Nrpickle/BIS/doc/display board/BIS Display Board Prototype - Initial Build.jpg

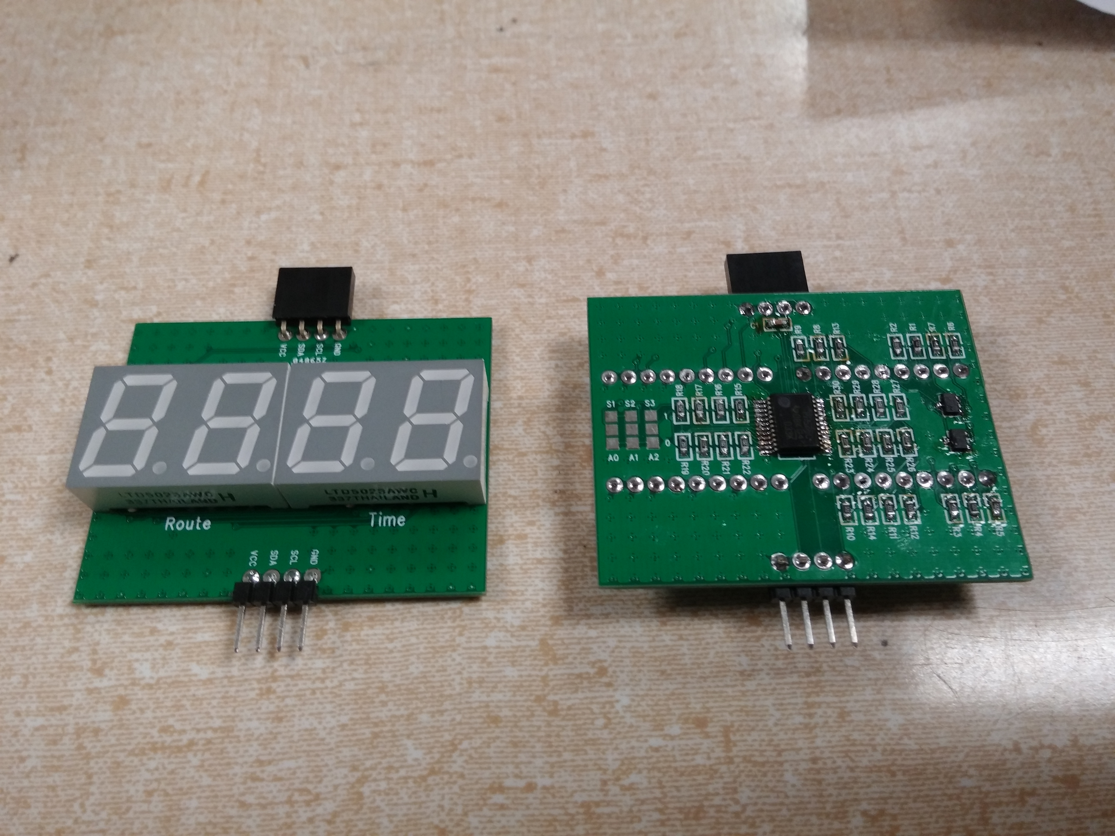
doc/display board/BIS Display Board Prototype - Initial Build.jpg
