Nrpickle/BIS/doc/display board/7 segment configuration.jpg

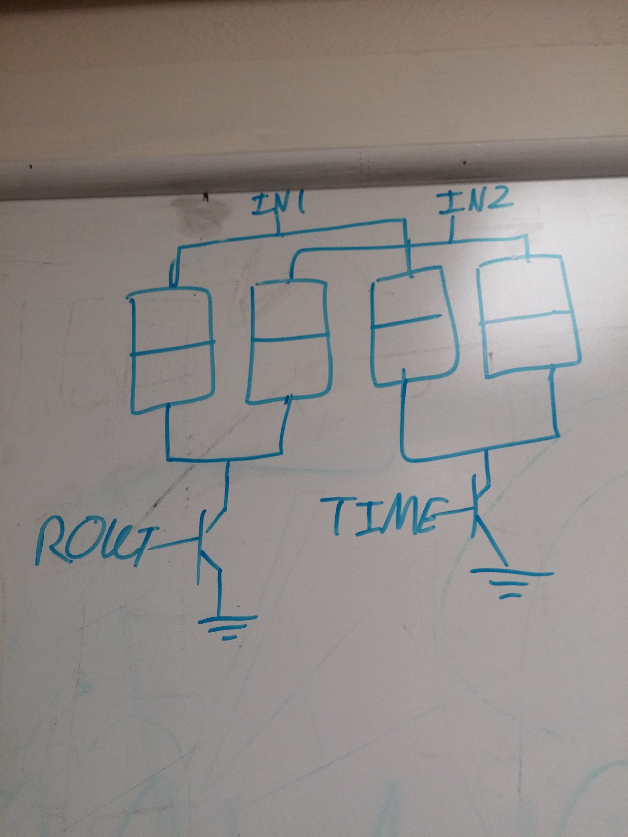
doc/display board/7 segment configuration.jpg
