Nrpickle/BIS/README.md

BIS
===

A repo for my Bus Information System. 

This device will take the bus route information from the Corvallis (OR) transit system and output it on 7 segment displays. 

This project is my first experience with the ESP8266 $5 WiFi module.
