Nrpickle/BIS/doc/display board/I2C Breakout v 0_1 Prototype Schematic.png

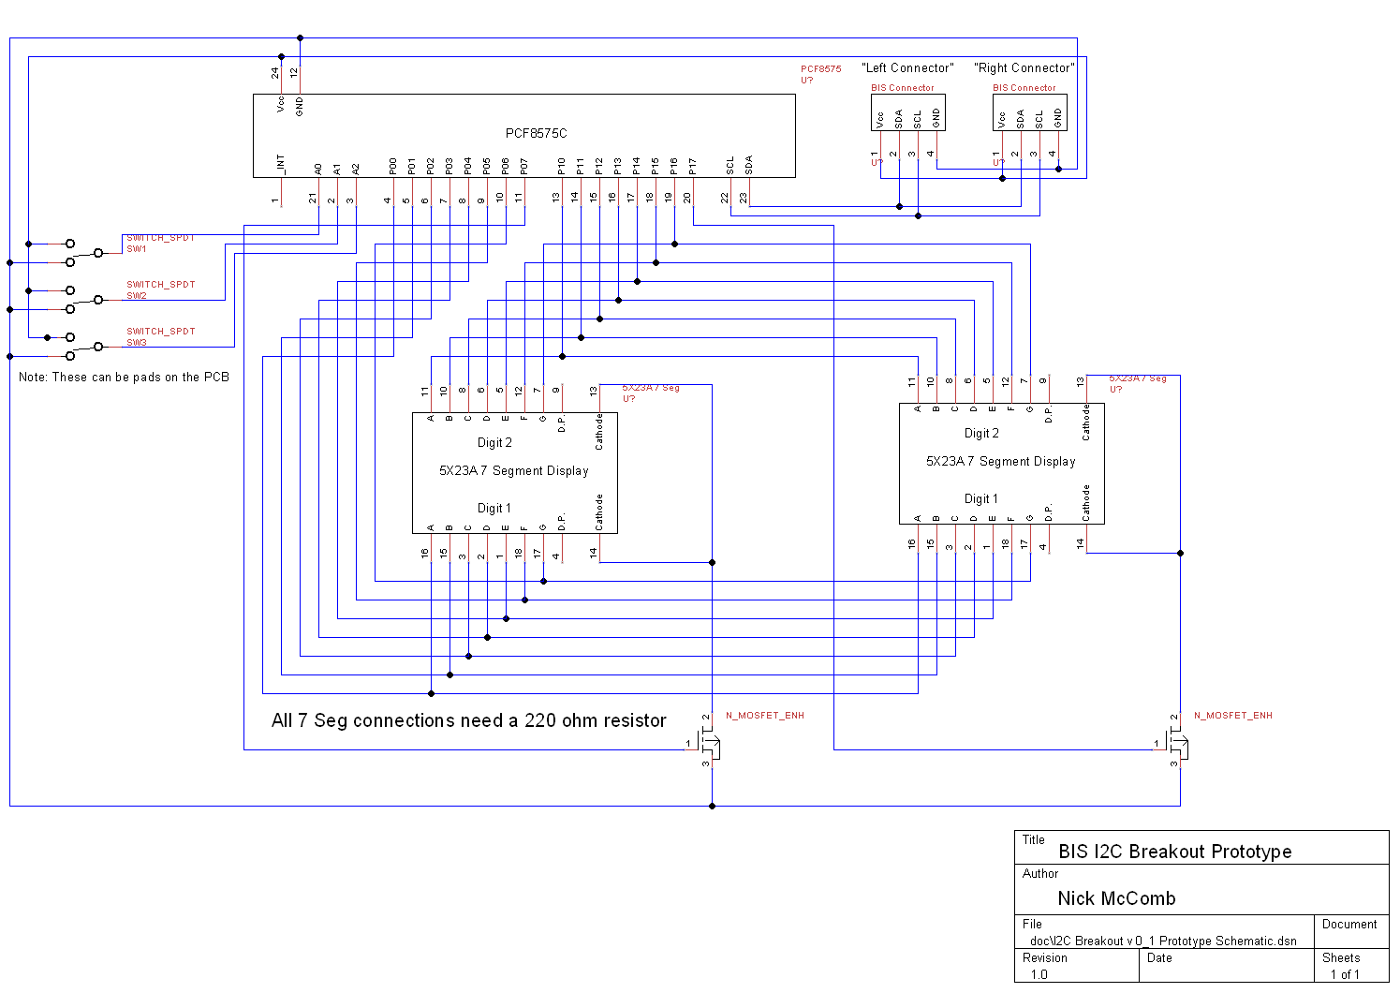
doc/display board/I2C Breakout v 0_1 Prototype Schematic.png
