Nrpickle/BIS/doc/display board/I2C-Breakout-Board-Layout.png

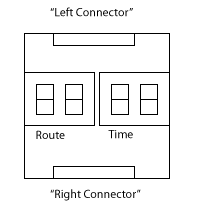
doc/display board/I2C-Breakout-Board-Layout.png
