Nrpickle/BIS/doc/display board/rev2/I2C Breakout v0.2 Prototype Schematic Sheet 1.png

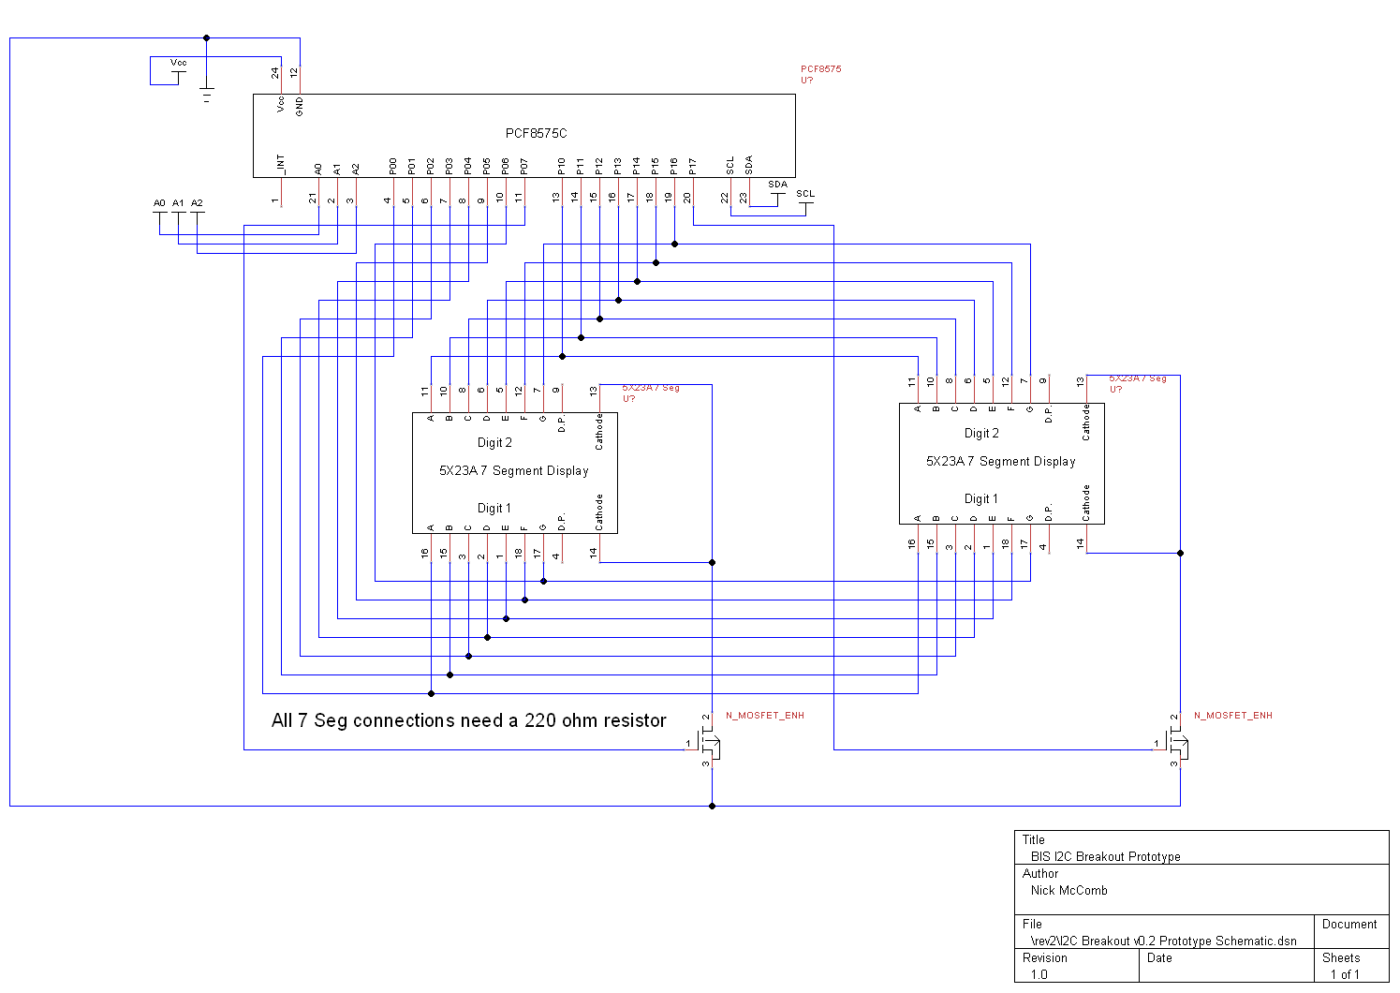
doc/display board/rev2/I2C Breakout v0.2 Prototype Schematic Sheet 1.png
