Nrpickle/BIS/doc/esp-01 pinout.png

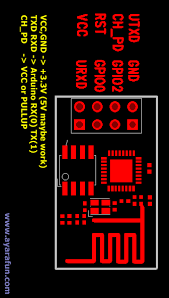
doc/esp-01 pinout.png
