Nrpickle/BIS/hardware/Drive Board/Schematic.png

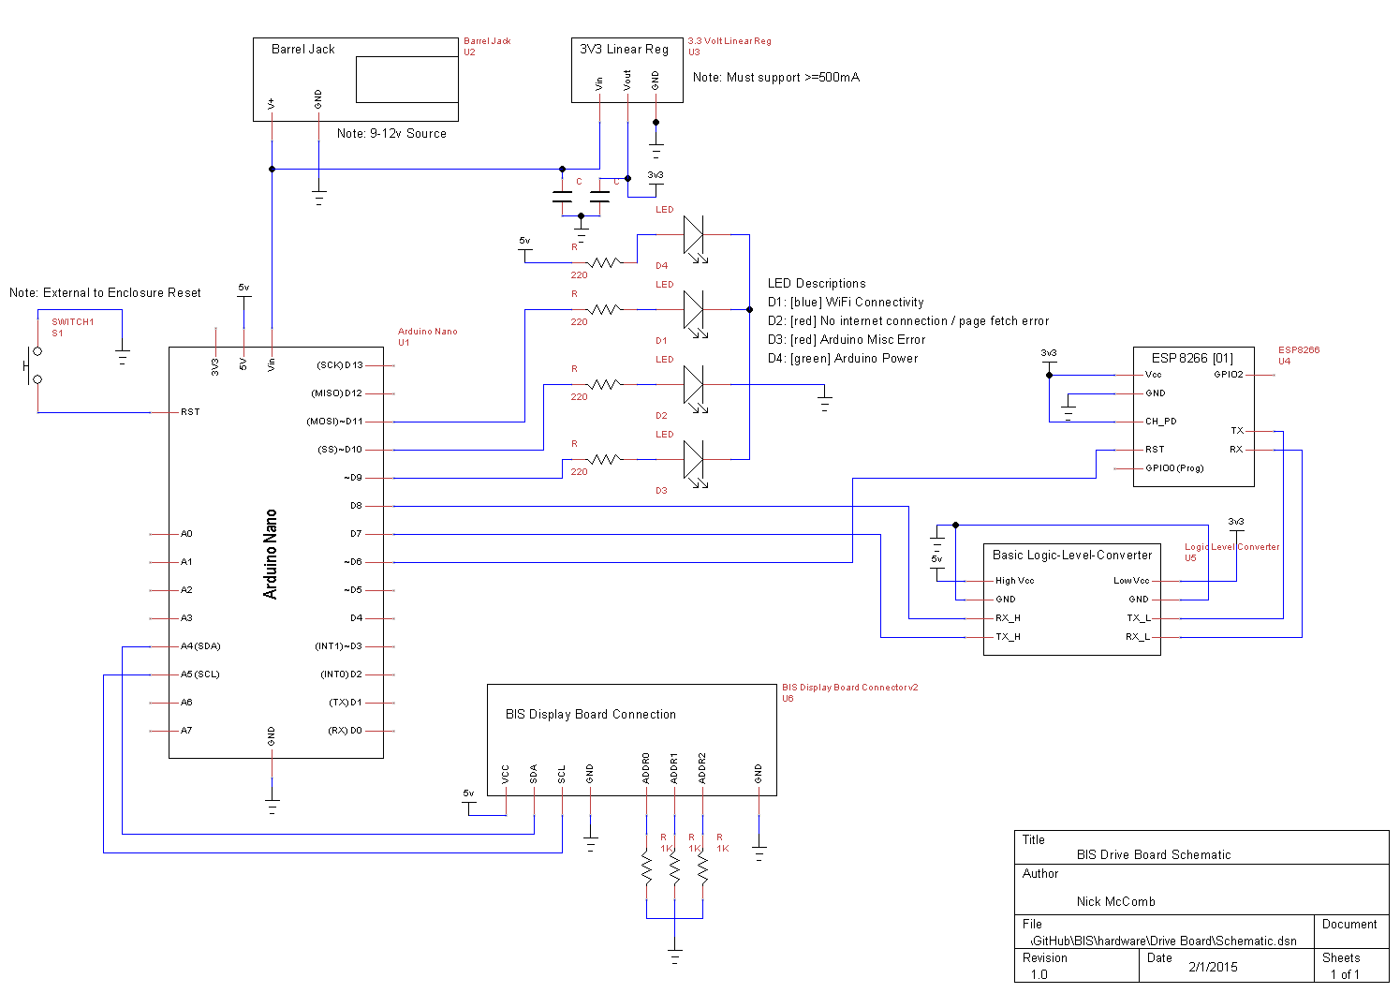
hardware/Drive Board/Schematic.png
