Nrpickle/BIS/hardware/ESP8266 Dev Board/Schematic.png

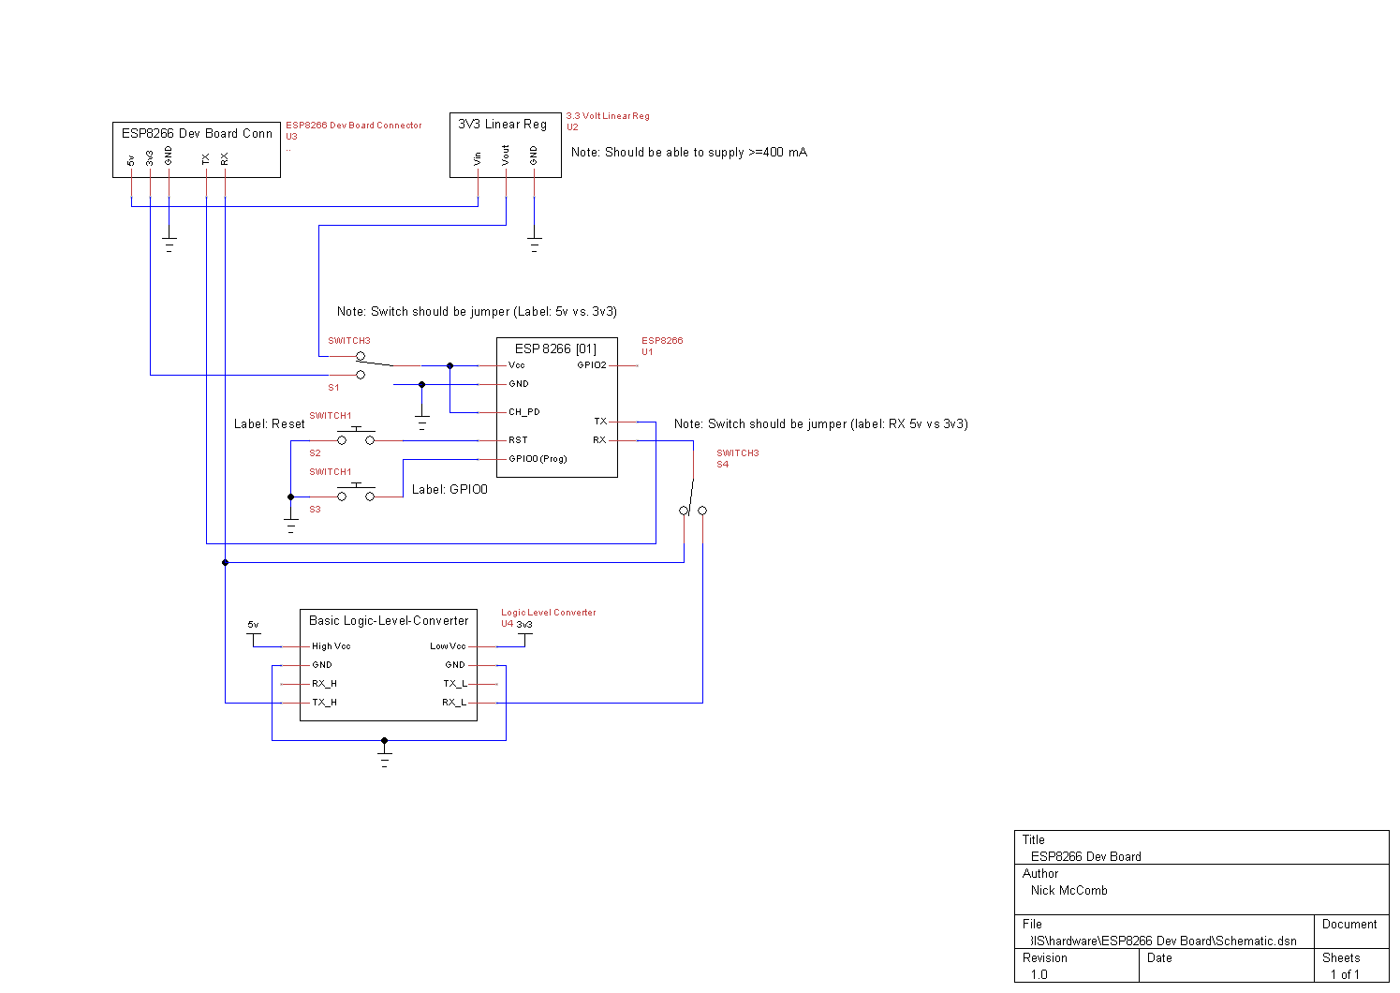
hardware/ESP8266 Dev Board/Schematic.png
