Nrpickle/BIS/hardware/Display Board Enclosure/Bottom Case.SLDPRT

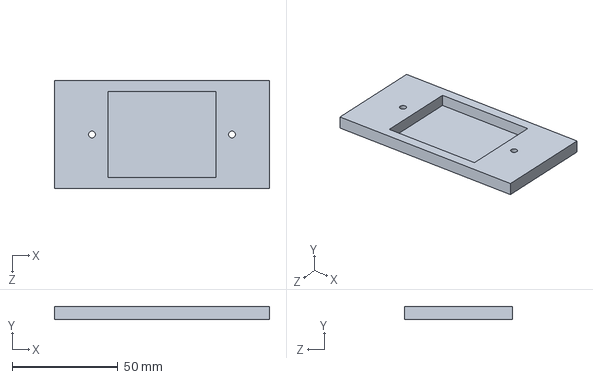
[picture p10: CAD file, 2015-01-18]
hardware/Display Board Enclosure/Bottom Case.SLDPRT
101.6 x 6.00 x 50.8 mm
