Nrpickle/BIS/hardware/Display Board Enclosure/Top Case.SLDPRT

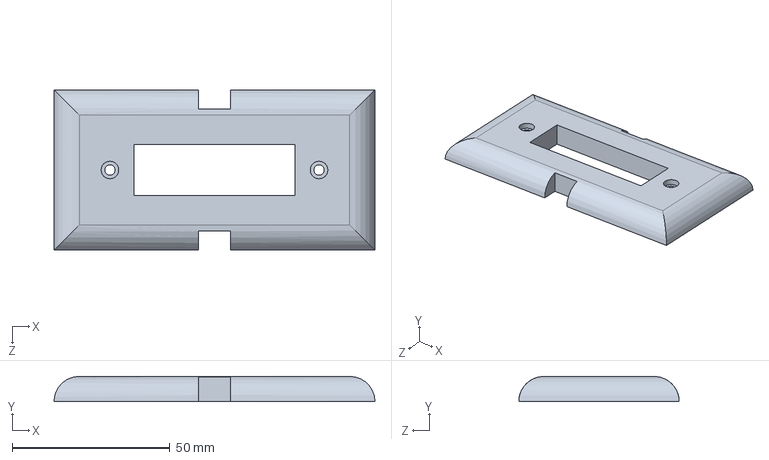
[picture p11: CAD file, 2015-01-18]
hardware/Display Board Enclosure/Top Case.SLDPRT
101.6 x 8.00 x 50.8 mm
