Nrpickle/BIS/hardware/Display Board/rev1/BIS_Display.pdf

D

6 | 5 | 4 | 3 | 2 | 1

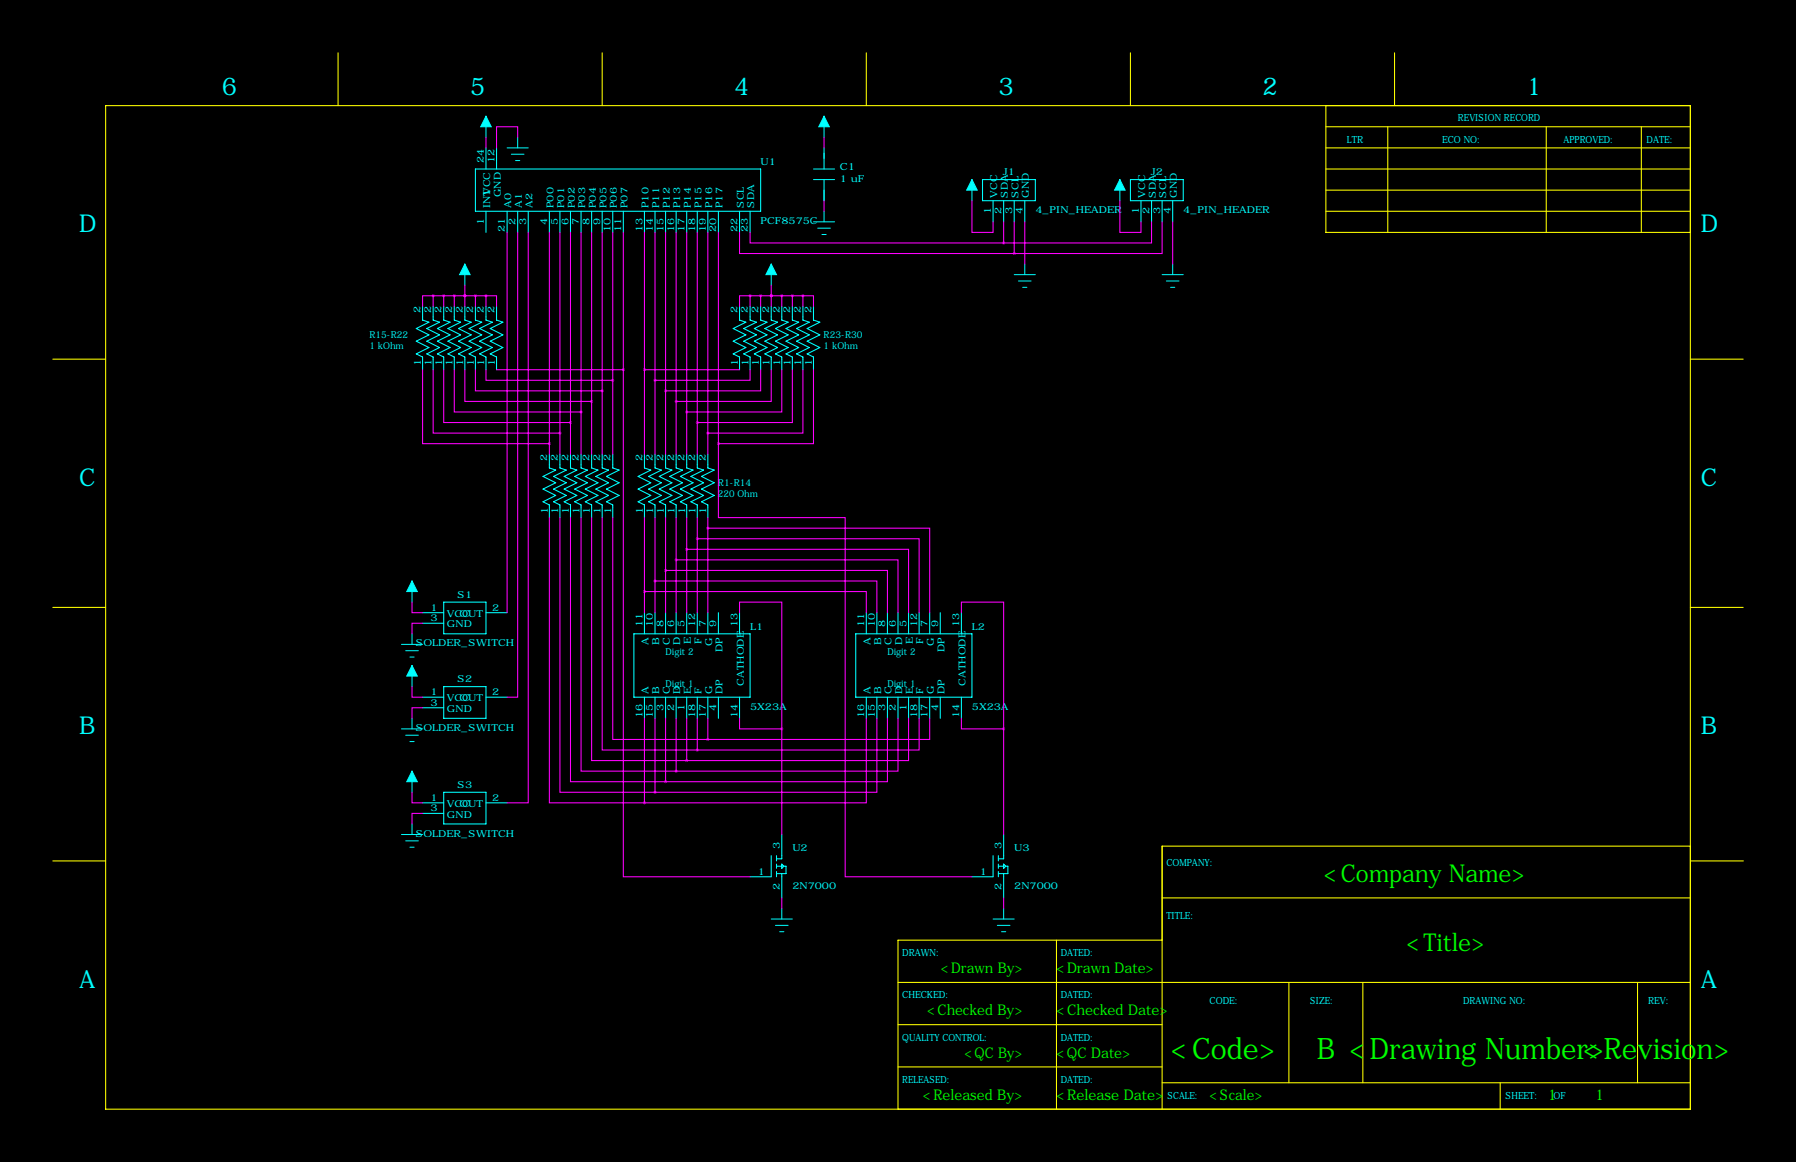
[picture p12: page 1]

REVISION RECORD

LTR | ECO NO: | APPROVED: | DATE:

DRAWN: <Drawn By> | DATED: <Drawn Date>

CHECKED: <Checked By> | DATED: <Checked Date> | CODE: | SIZE: | DRAWING NO: | REV:

QUALITY CONTROL: <QC By> | DATED: <QC Date>

RELEASED: <Released By> | DATED:

<Scale> SCALE: | 1 1 SHEET: OF
