Nrpickle/BIS/(list of files, drawings)

Other design files:
doc/display board/I2C Breakout v 0_1 Prototype Schematic.dsn
doc/display board/rev2/I2C Breakout v0.2 Prototype Schematic.dsn
hardware/Display Board/rev1/BIS_Display.pcb
hardware/Drive Board/Schematic.dsn
hardware/ESP8266 Dev Board/Schematic.dsn
