Nrpickle/BIS/hardware/I2C Expander/Sparkfun PCF8575C_Breakout-v10/PCF8575C_v10 Indivdual.brd

## EAGLE design hardware/I2C Expander/Sparkfun PCF8575C_Breakout-v10/PCF8575C_v10 Indivdual.brd (2014-12-12)

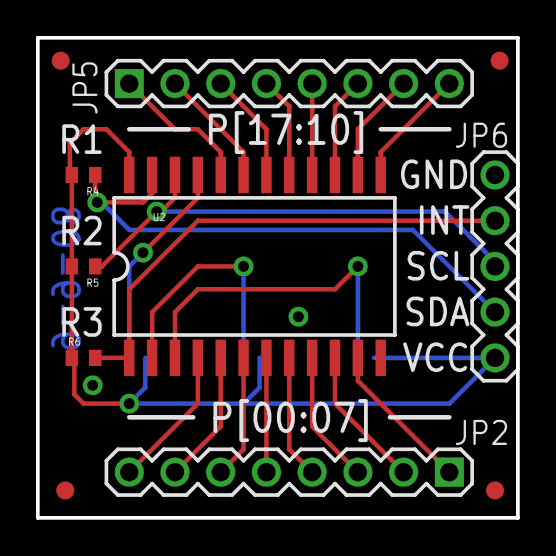
[picture p13: board PCF8575C_v10 Indivdual.brd from above]

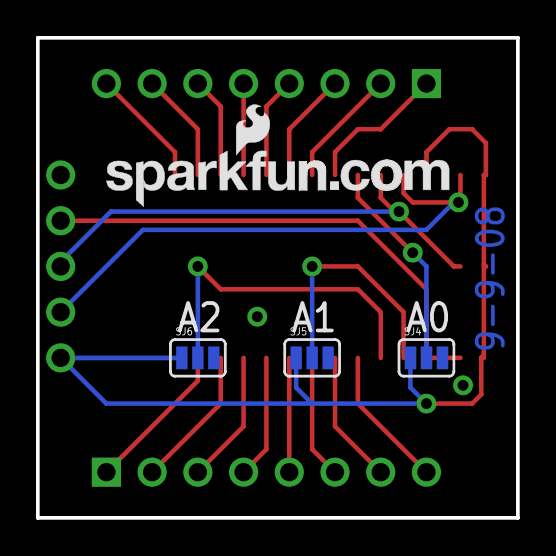
[picture p14: board PCF8575C_v10 Indivdual.brd from below]

Board: 2 copper layers, 26.7 x 26.7 mm, 15 parts (4 on the bottom side), 24 nets.

Parts:
E$5, E$6, E$7, E$8: FIDUCIAL-1X2
JP2, JP5: 1X08
JP6: 1X05
R4, R5, R6: C0402
SJ4: A0; SJ_3
SJ5: A1; SJ_3
SJ6: A2; SJ_3
U2: PCF8575C; SO-24DW
U$1: LOGO-SFENEW; SFE-NEW-WEBLOGO

Connections:
A3: SJ4.2, U2.21
A4: SJ5.2, U2.2
A5: SJ6.2, U2.3
GND1: JP6.1, SJ4.3, SJ5.3, SJ6.3, U2.12
INT1: JP6.2, R6.2, U2.1
P1: JP5.1, U2.20
P2: JP5.2, U2.19
P3: JP5.3, U2.18
P4: JP5.4, U2.17
P5: JP5.5, U2.16
P6: JP5.6, U2.15
P7: JP5.7, U2.14
P8: JP5.8, U2.13
PO8: JP2.8, U2.4
PO9: JP2.7, U2.5
PO10: JP2.5, U2.7
PO11: JP2.4, U2.8
PO12: JP2.3, U2.9
PO13: JP2.2, U2.10
PO14: JP2.1, U2.11
PO15: JP2.6, U2.6
SCL1: JP6.3, R5.1, U2.22
SDA1: JP6.4, R4.1, U2.23
VCC1: JP6.5, R4.2, R5.2, R6.1, SJ4.1, SJ5.1, SJ6.1, U2.24
