Nrpickle/BIS/doc/Wiring-Diagram-for-BIS-Prototype.png

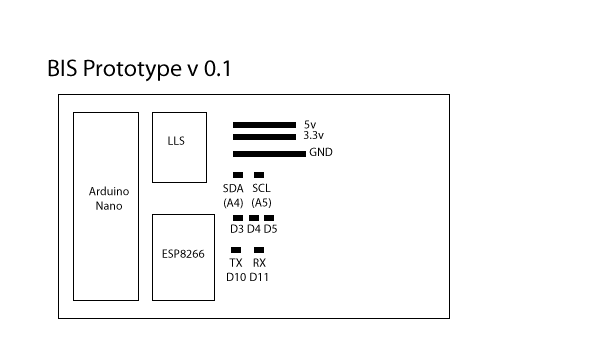
doc/Wiring-Diagram-for-BIS-Prototype.png
