Nrpickle/BIS/(commit log)

2014-12-12 Added layout diagram
    Added diagram that describes the physical layout of the prototype
2014-12-12 Added PCF8575C Breakout Board files
    [PCF8575C_Breakout-v10.sch, PCF8575C_Panel-v10.brd, PCF8575C_v10 Indivdual.brd]
2014-12-12 Added Pin Allocation Info
2014-12-13 Added I2C PCB Prototype Schematic
    [I2C Breakout v 0_1 Prototype Schematic.dsn]
2014-12-13 Added I2C Break
2014-12-16 Clarified Documentation
    [PCF8575C_Breakout-v10.sch, PCF8575C_Panel-v10.brd, PCF8575C_v10 Indivdual.brd]
2014-12-20 Updated PCB Prototype Schematic
    Added requirement for 220 ohm resistors
    [I2C Breakout v 0_1 Prototype Schematic.dsn]
2014-12-20 Small Schematic Fix
    [I2C Breakout v 0_1 Prototype Schematic.dsn]
2014-12-27 BIS Display PCBs Added
    Display Board schematic ported from TinyCAD into PADS and used to
    generate PCB layout file.
    [BIS_Display.pcb, BIS_Display.sch]
2014-12-27 PCF8575C Silkscreen Fixed
    IC outline appeared in PADS but not in generated Gerber.
    [BIS_Display.pcb]
2014-12-27 Decoupling Cap and Ground Plane Added
    Additions to help with high speed communication added.
    [BIS_Display.pcb, BIS_Display.sch]
2014-12-27 Resistors Added to Display Board
    Pullup and current limiting resistors have been added to the design.
    [BIS_Display.pcb, BIS_Display.sch]
2014-12-27 Resistor Number Reduced
    14 220 Ohm resistors reduced by placing them on common cathodes.
    [BIS_Display.pcb, BIS_Display.sch]
2014-12-27 Revert "Resistor Number Reduced"
    This reverts commit 881abcf642ee9551273dd546ed50deaea26de49b.
    [BIS_Display.pcb, BIS_Display.sch]
2014-12-27 PCF8575C Footprint Changed
    PCF8575CDBQ is non-stocked so the footprint has been changed to
    PCF8575CDB.
    [BIS_Display.pcb, BIS_Display.sch]
2014-12-27 Transistor Pin Issue Fixed
    Source and Drain were reversed in the part decal.
    [BIS_Display.pcb, BIS_Display.sch]
2015-01-10 Reorganized docs
    [I2C Breakout v 0_1 Prototype Schematic.dsn]
2015-01-17 Added Bare Minimum Disp Board Control
2015-01-18 Display Board Enclosure SolidWorks Parts Added
    The first revision for the 3D printed display board enclosure.
    [Bottom Case.SLDPRT, Top Case.SLDPRT]
2015-01-24 Added HW Requirements for Drive and Display
    [BIS_Display.pcb, BIS_Display.sch]
2015-01-24 Added Timer library
2015-01-24 Added the I2C object to the struct, added error state to configureToWrite
    [MainControlFirmware.ino]
2015-01-24 Added TimerOne library
2015-01-24 Moved state machine switch to ISR
2015-01-27 Added ESP8266 Documentation / Serial Test Arduino Sketch
2015-01-27 Added HW Requirements for ESP 8266 Dev Board
2015-01-27 Made LED indicate WiFi connectivity
2015-01-27 Changed HW Requirements to add LED to board
2015-01-27 [Not Working] Attempt to connect to CTS
    [ESPNano.ino]
2015-01-27 Added HW Requirements - Indicator LEDs
2015-02-02 Added Drive Board Schematic
    [Schematic.dsn]
2015-02-02 Updated Drive Board Schematic
    [Schematic.dsn]
2015-02-02 Finalized Current Version of Drive Board Schematic
    [Schematic.dsn]
2015-02-02 Added second version of Display Board
    [I2C Breakout v0.2 Prototype Schematic.dsn]
2015-02-02 Updated v.2 of Display Board Schematic
2015-02-02 Exported image of schematic
2015-02-02 Added pngs of Sheets
    [I2C Breakout v0.2 Prototype Schematic.dsn]
2015-02-02 Added initial Dev Board Schematic
    [Schematic.dsn]
2015-02-02 Updated ESP Dev Board Schematic
2015-02-02 Changed Drive Board Schematic
    [Schematic.dsn]
2015-02-03 Added Current ESP Development Code
2015-02-03 [Not Working] Changed Server/Page Request
    This has not been tested, looking to revert back to a previous version
    [ESPNano.ino]
2015-02-24 [Not Working] Added Reset Feature
    [ESPNano.ino]
2018-03-24 Added PDF of display board
